grantbreaksthings/VinesauceTMGBadge/vine_badge.pdf

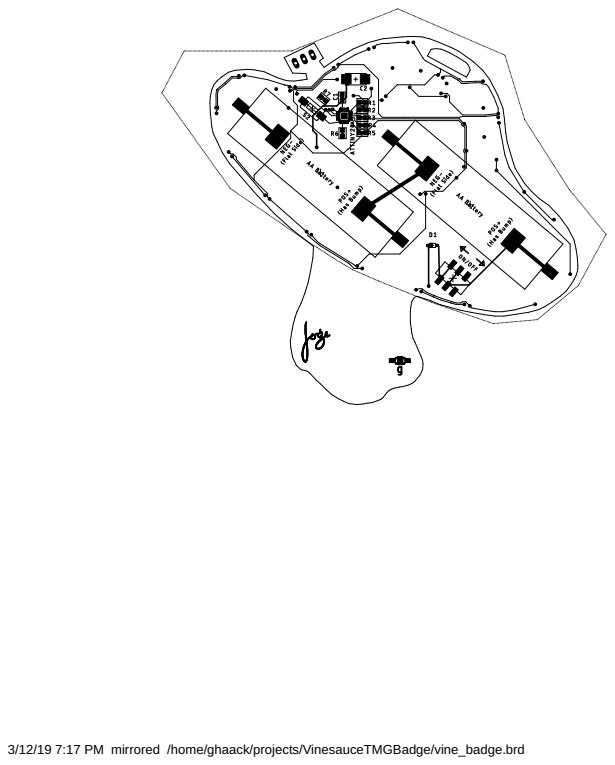
[picture p1: page 1]

3/12/19 7:17 PM mirrored /home/ghaack/projects/VinesauceTMGBadge/vine_badge.brd
